Lenger3/esp32-rfid-ev-charger/hardware/LEHIM-SABLONU.pdf

# LEHIM SABLONU — 100 x 100 mm · 1:1 OLCek

Yazdirirken 'Actual size / %100' secin. Cetvel kontrolu: alttaki 50 mm olcegi olcun.

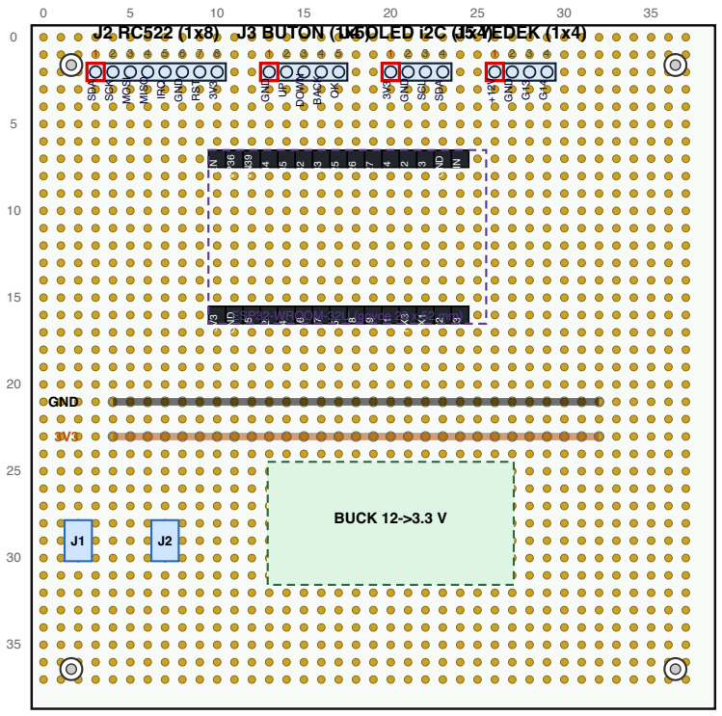
[picture p5: figure]
SDA; SCK; MOSI; MISO; IRQ; GND; RST; DOWN; BACK; J3 BUTON (1x5); SCL; J4 OLED i2C (1x4); J5 YEDEK (1x4); VIN; ESP32; -WROOM-32U (govde 26 x 52 mm); BUCK 12->3.3 V

0 | 10 | 20 | 30 | 40 | 50

OLCEK KONTROLU: bu cizgi tam 50 mm olmali

# LEHIM SIRASI

### 0 Olcek kontrolu: 50 mm cizgisi tam 50 mm mi?

### 1 GND rayi (satir 21, kolon 4-32) — 8 pin

2 3V3 rayi (satir 23, kolon 4-32) — 8 pin

### 3 ESP32 2x15 soket — once modulle hizala

### 4 J2 RC522 (satir 2, kolon 3-10)

### 5 J3 BUTON (satir 2, kolon 13-17)

### 6 J4 OLED i2C (satir 2, kolon 20-23)

### 7 J5 YEDEK (satir 2, kolon 26-29)

### 8 J1 + J2 12V klemens (satir 29)

### 9 Buck cikisi raylara + 100uF

### 10 Guc verme testi: 3V3 rayinda 3.3 V

### 11 Modulleri tak, firmware yukle

## KRITIK

- Kirmizi kare = pin 1. Tum header'larda ayni yon.
- RC522'ye 5 V VERME — aninda olur.
- Raylar birbirine degmemeli: 2 delik (5.08 mm) ara var.
- ESP32 sirasi 22.86 mm = 9 delik. Kayarsa modul girmez.
- OLED'e giden 4 tel: 3V3, GND, SCL(G22), SDA(G21)
- RES/A0/CS modul tarafinda: RES->3V3, A0->GND, CS->GND
