Lenger3/esp32-rfid-ev-charger/docs/img/panel-device.png

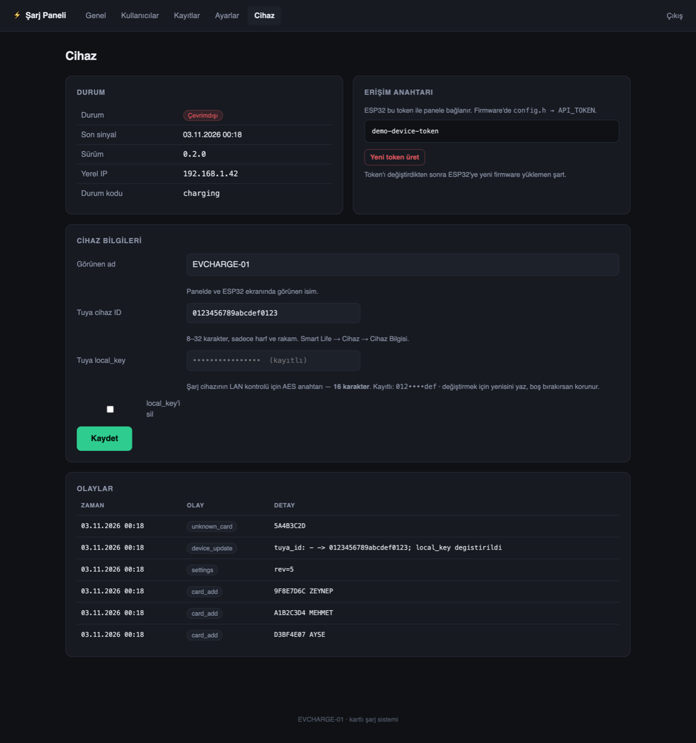
docs/img/panel-device.png
