Lenger3/esp32-rfid-ev-charger/docs/img/panel-sessions.png

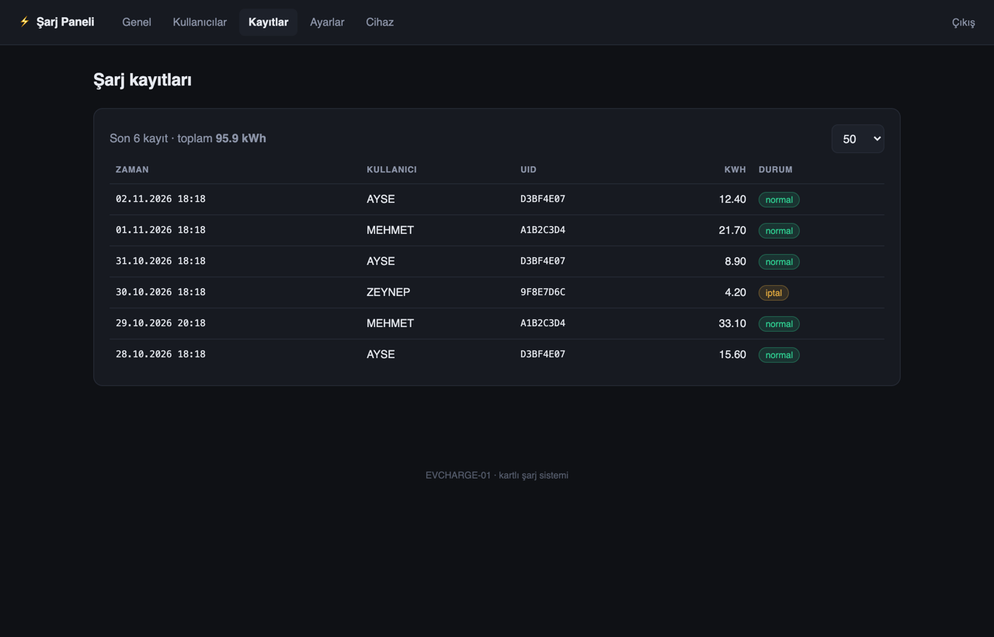
docs/img/panel-sessions.png
