Lenger3/esp32-rfid-ev-charger/docs/img/panel-users.png

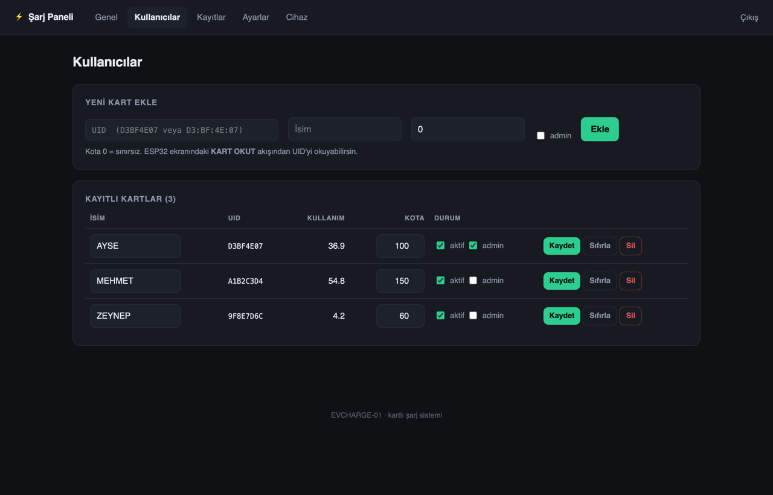
docs/img/panel-users.png
