Lenger3/esp32-rfid-ev-charger/docs/img/pcb-layout.png

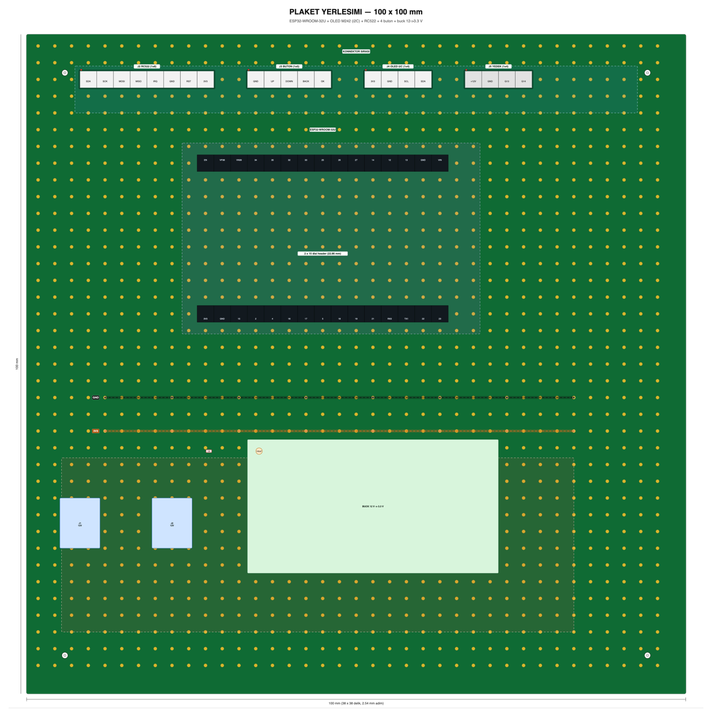
docs/img/pcb-layout.png
