Lenger3/esp32-rfid-ev-charger/docs/img/pcb-moduls.png

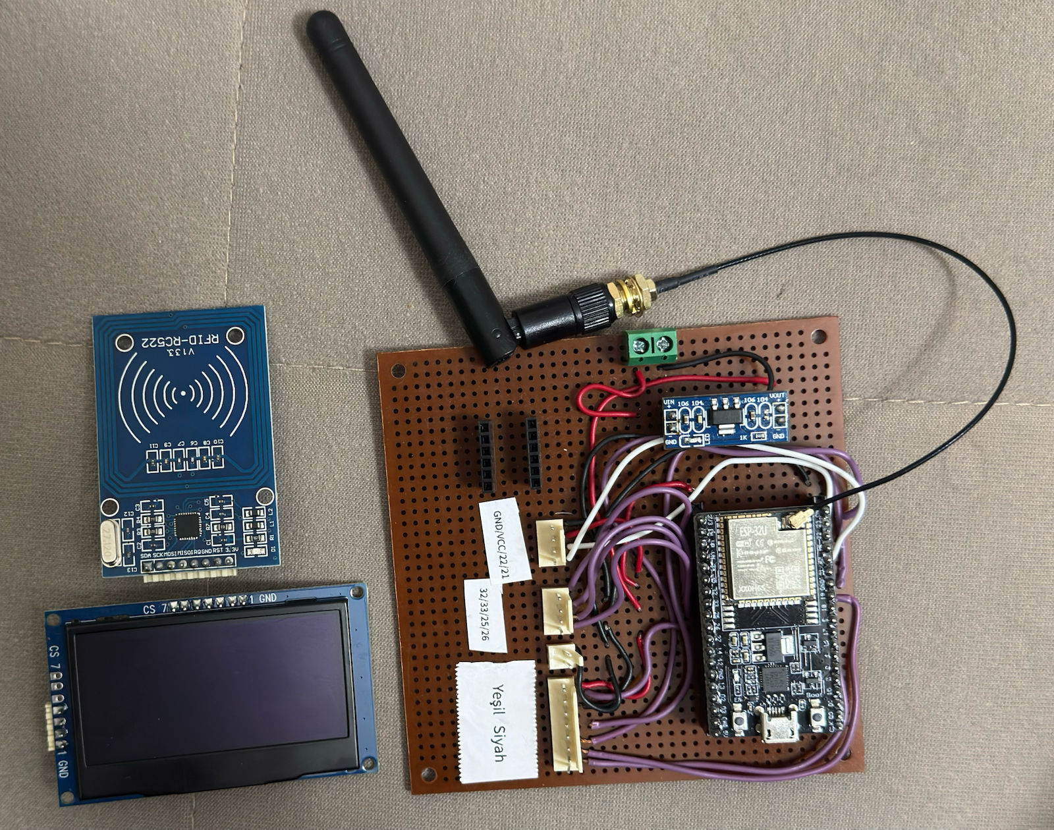
docs/img/pcb-moduls.png
