Lenger3/esp32-rfid-ev-charger/docs/img/social-preview.png

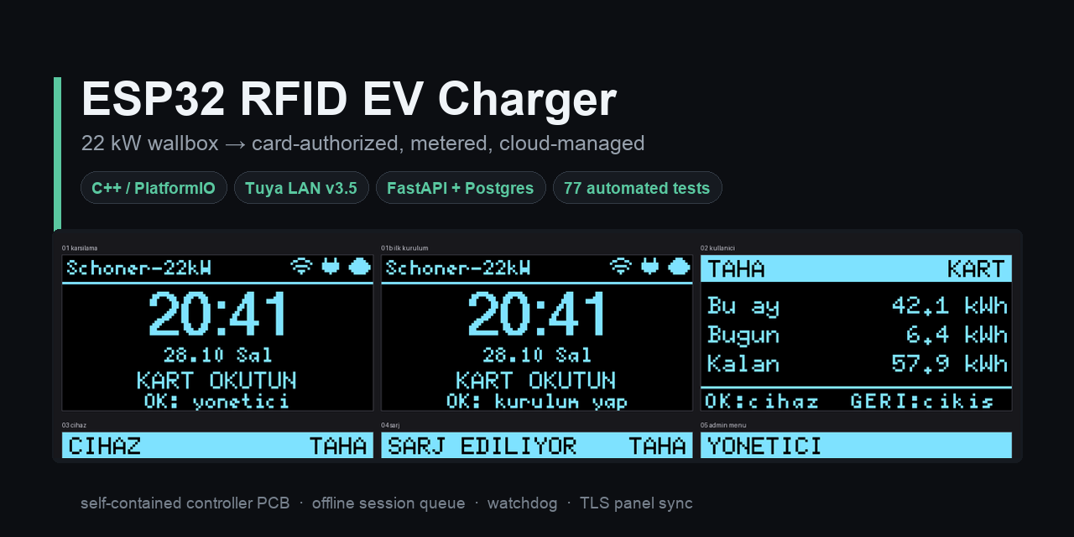
docs/img/social-preview.png
