Lenger3/esp32-rfid-ev-charger/firmware/kart_sistem/sim/out/01_karsilama.png

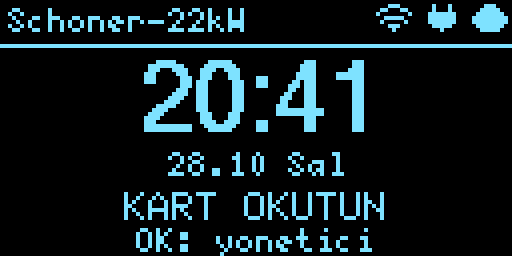
firmware/kart_sistem/sim/out/01_karsilama.png
