Lenger3/esp32-rfid-ev-charger/firmware/kart_sistem/sim/out/02_kullanici.png

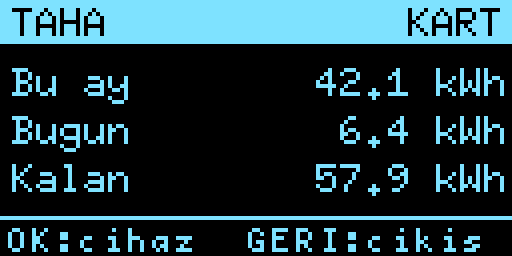
firmware/kart_sistem/sim/out/02_kullanici.png
