Lenger3/esp32-rfid-ev-charger/firmware/kart_sistem/sim/out/03_cihaz.png

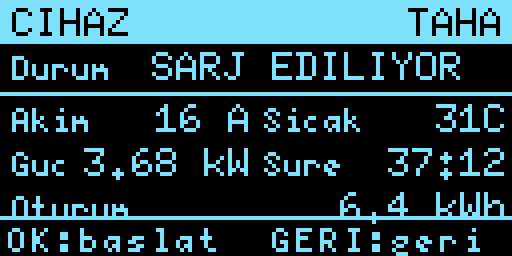
firmware/kart_sistem/sim/out/03_cihaz.png
