Lenger3/esp32-rfid-ev-charger/firmware/kart_sistem/sim/out/04_sarj.png

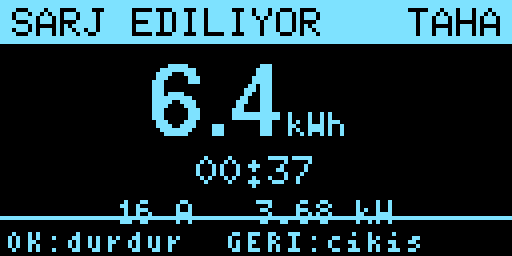
firmware/kart_sistem/sim/out/04_sarj.png
