Lenger3/esp32-rfid-ev-charger/firmware/kart_sistem/sim/out/05_admin_menu.png

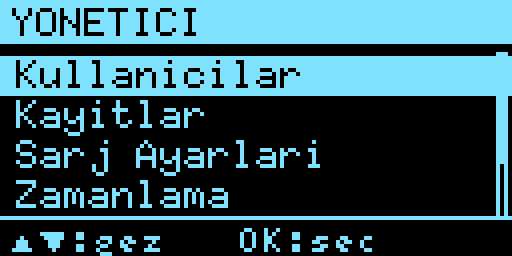
firmware/kart_sistem/sim/out/05_admin_menu.png
