Lenger3/esp32-rfid-ev-charger/firmware/kart_sistem/sim/out/06_kullanicilar.png

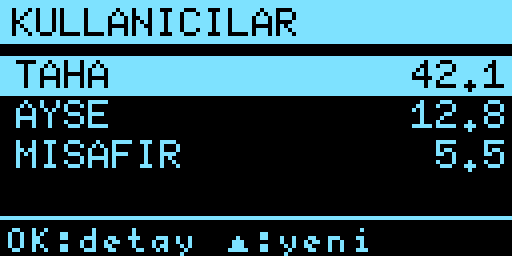
firmware/kart_sistem/sim/out/06_kullanicilar.png
