Lenger3/esp32-rfid-ev-charger/firmware/kart_sistem/sim/out/07_kayitlar.png

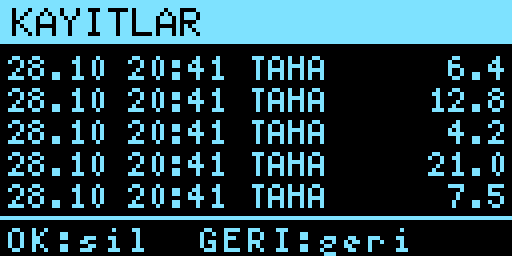
firmware/kart_sistem/sim/out/07_kayitlar.png
