Lenger3/esp32-rfid-ev-charger/firmware/kart_sistem/sim/out/08_ayarlar.png

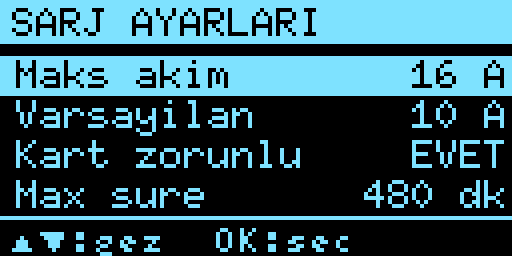
firmware/kart_sistem/sim/out/08_ayarlar.png
