Lenger3/esp32-rfid-ev-charger/firmware/kart_sistem/sim/out/09_zamanlama.png

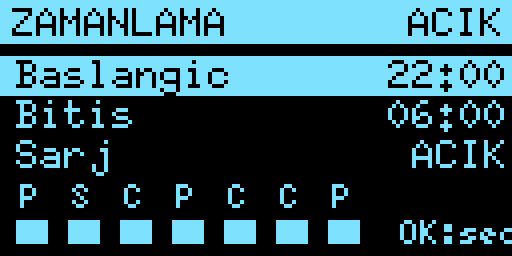
firmware/kart_sistem/sim/out/09_zamanlama.png
