Lenger3/esp32-rfid-ev-charger/firmware/kart_sistem/sim/out/10_pin.png

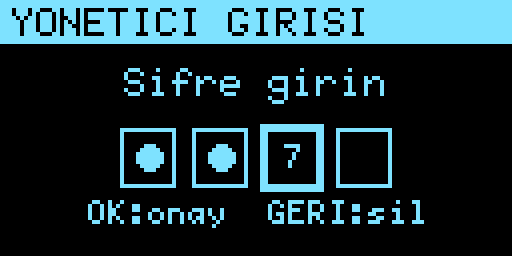
firmware/kart_sistem/sim/out/10_pin.png
