Lenger3/esp32-rfid-ev-charger/firmware/kart_sistem/sim/out/11_red.png

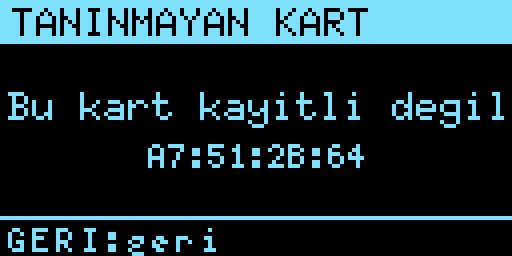
firmware/kart_sistem/sim/out/11_red.png
