Lenger3/esp32-rfid-ev-charger/firmware/kart_sistem/sim/out/12_cihazbilgi.png

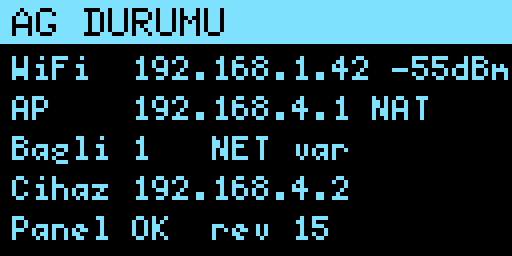
firmware/kart_sistem/sim/out/12_cihazbilgi.png
