Lenger3/esp32-rfid-ev-charger/firmware/kart_sistem/sim/out/13_butontest.png

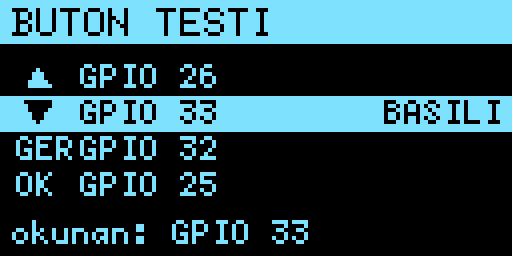
firmware/kart_sistem/sim/out/13_butontest.png
