Lenger3/esp32-rfid-ev-charger/firmware/kart_sistem/sim/out/14_menu_kaydirma.png

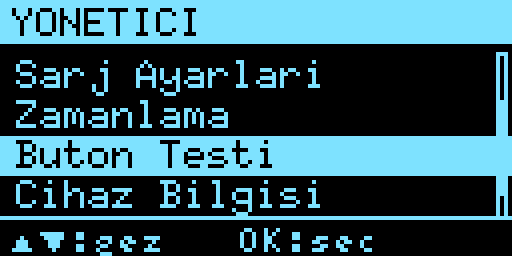
firmware/kart_sistem/sim/out/14_menu_kaydirma.png
