Lenger3/esp32-rfid-ev-charger/firmware/kart_sistem/sim/out/15_onay.png

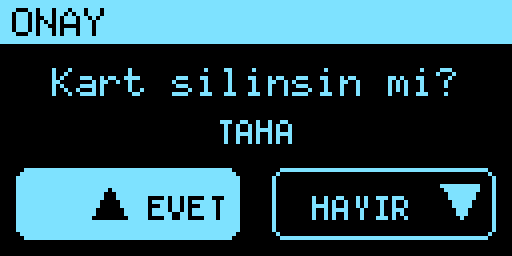
firmware/kart_sistem/sim/out/15_onay.png
