Lenger3/esp32-rfid-ev-charger/hardware/_pdf.png

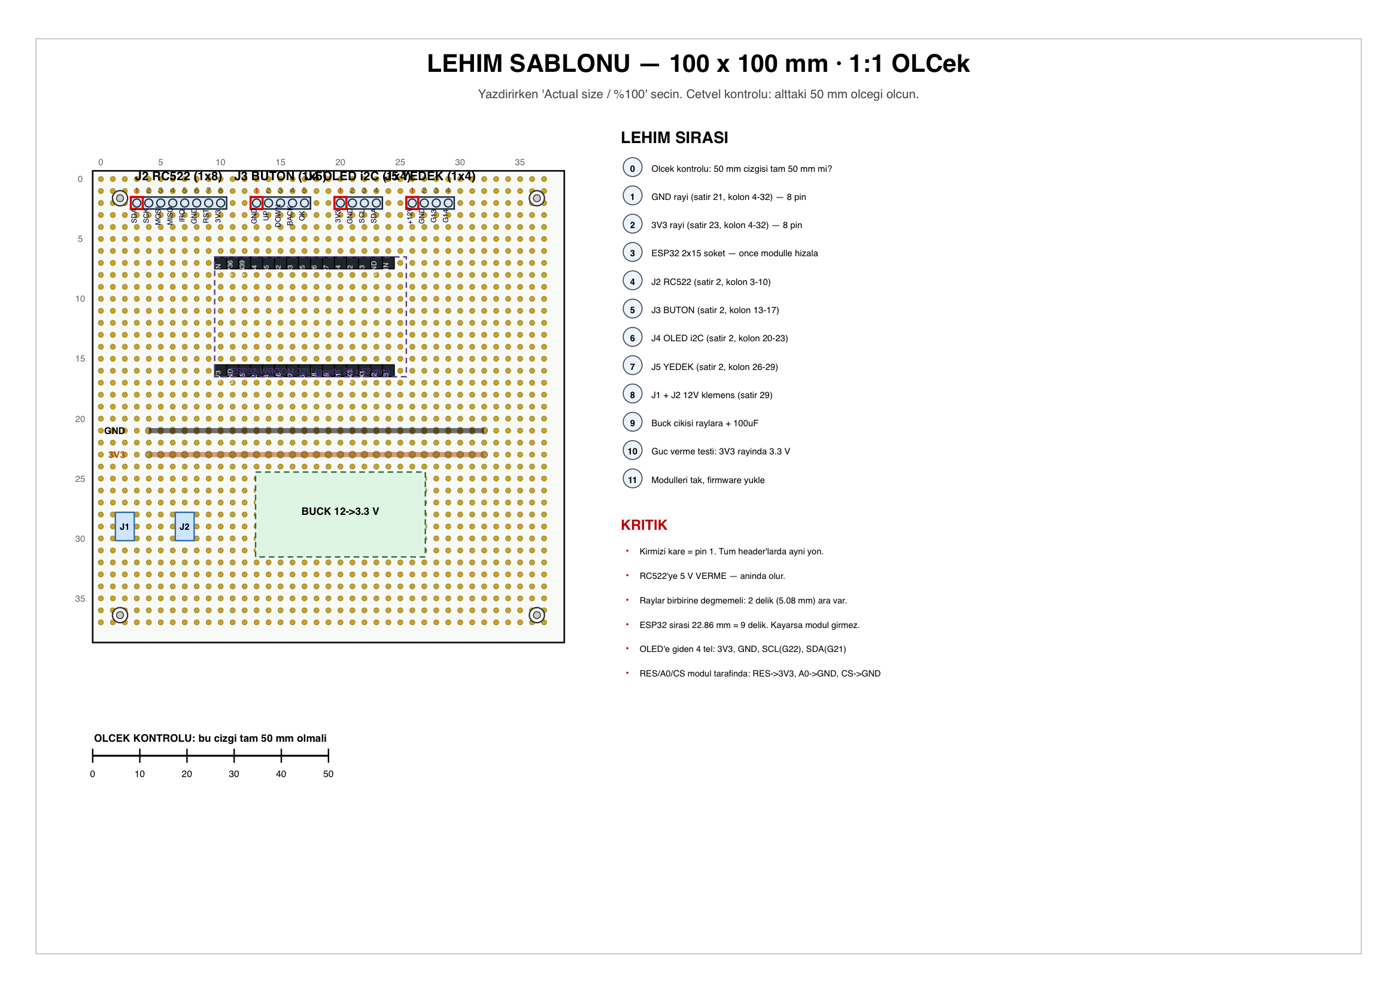
hardware/_pdf.png
