Lenger3/esp32-rfid-ev-charger/hardware/lid_bottom.png

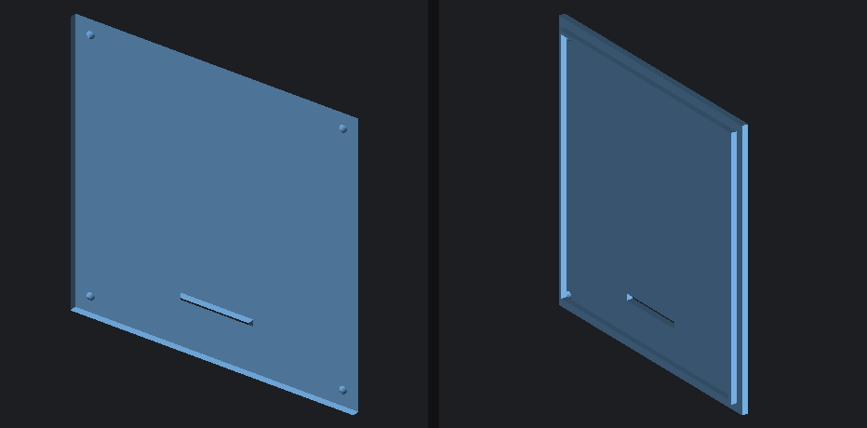
hardware/lid_bottom.png
