Lenger3/esp32-rfid-ev-charger/hardware/preview.png

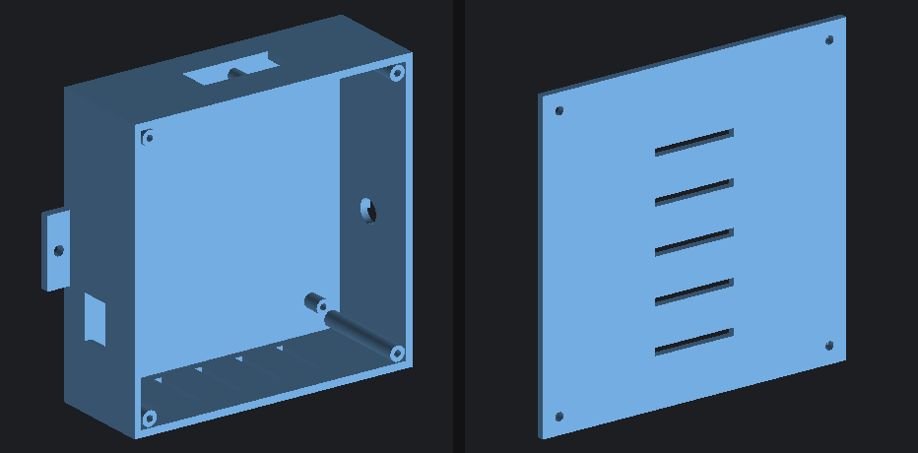
hardware/preview.png
