Lenger3/esp32-rfid-ev-charger/panel/screens/04_settings.png

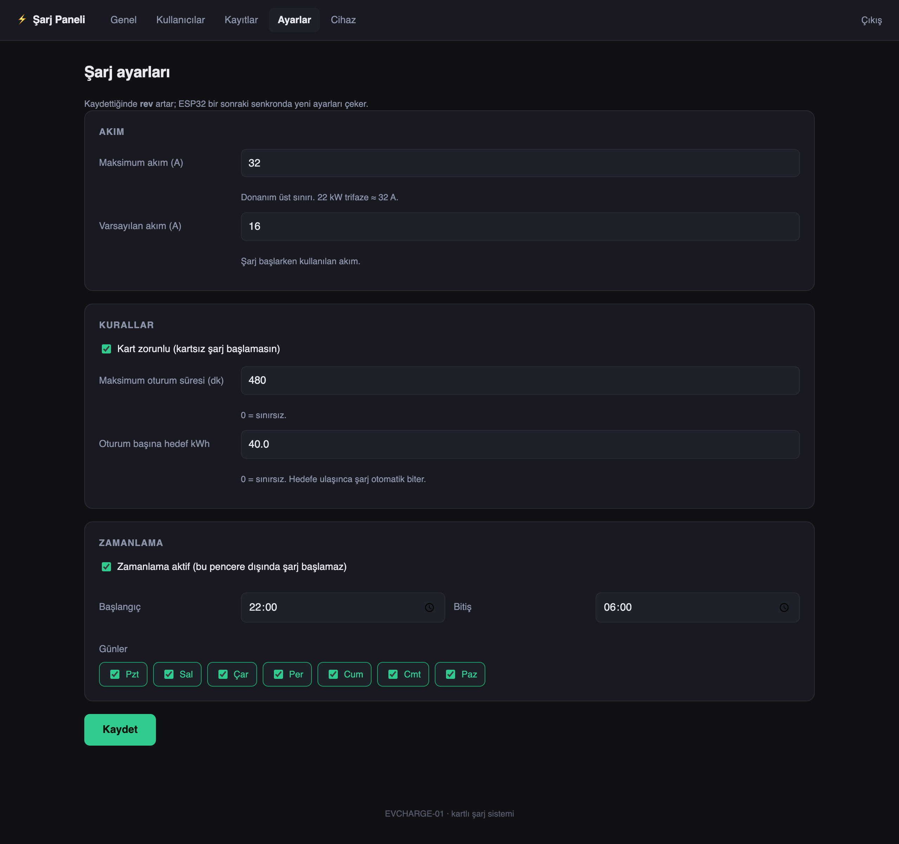
panel/screens/04_settings.png
