Lenger3/esp32-rfid-ev-charger/hardware/body_pcb.stl

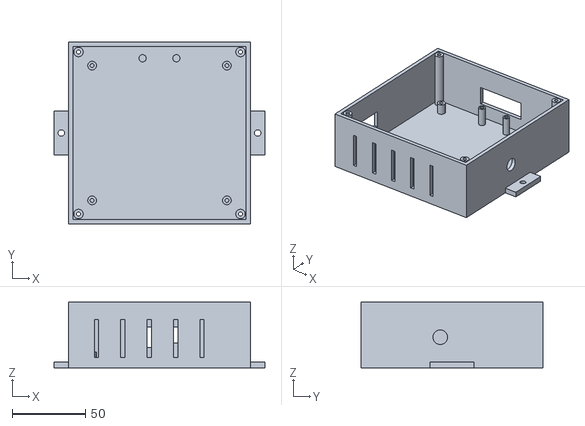
[picture p31: CAD file, 2026-11-03]
hardware/body_pcb.stl
144.0 x 124.0 x 45.0
