Lenger3/esp32-rfid-ev-charger/hardware/body.stl

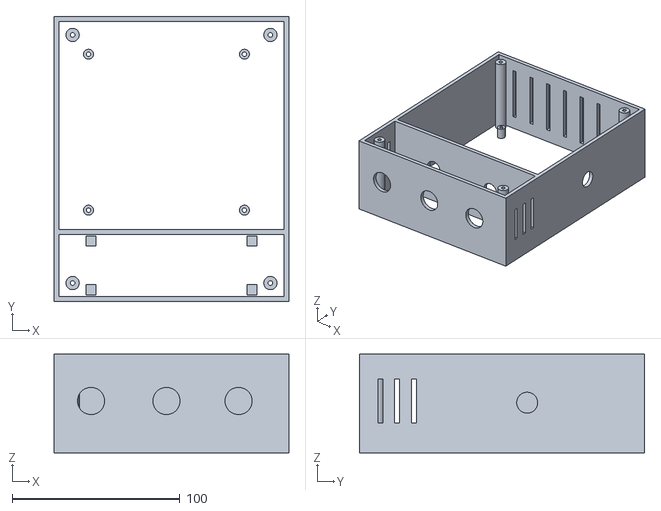
[picture p32: CAD file, 2026-11-03]
hardware/body.stl
140.0 x 170.0 x 59.0
