Lenger3/esp32-rfid-ev-charger/hardware/lid_pcb.stl

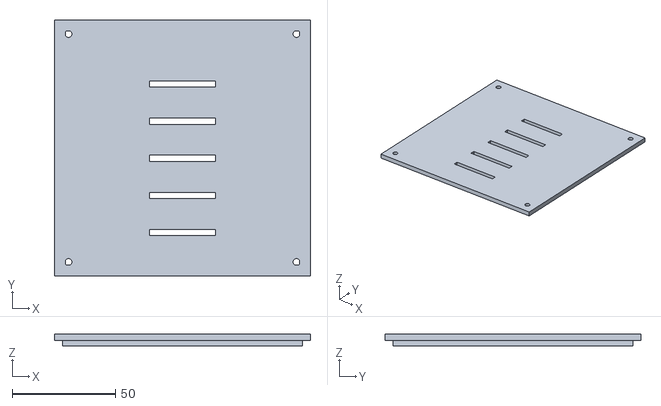
[picture p33: CAD file, 2026-11-03]
hardware/lid_pcb.stl
124.0 x 124.0 x 5.60
