Lenger3/esp32-rfid-ev-charger/hardware/lid.stl

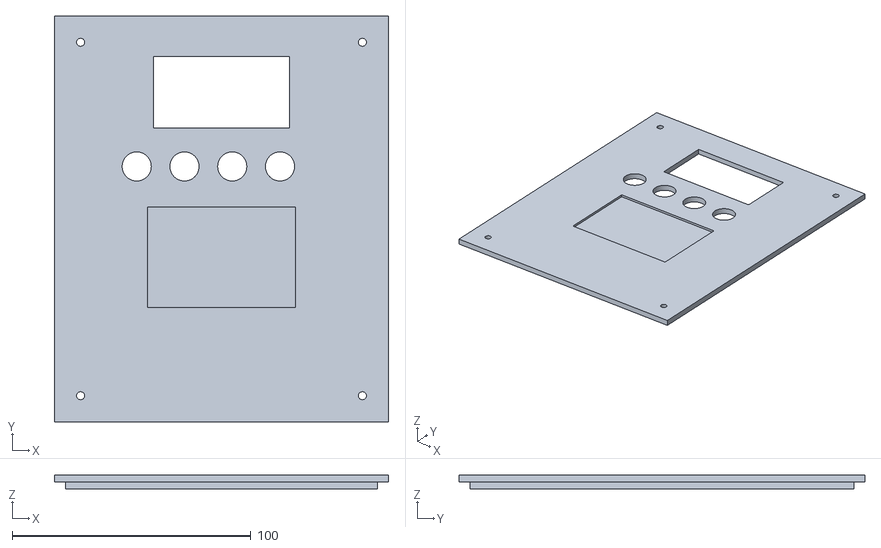
[picture p34: CAD file, 2026-11-03]
hardware/lid.stl
140.0 x 170.0 x 6.00
