Lenger3/esp32-rfid-ev-charger/hardware/pcb_wiring.png

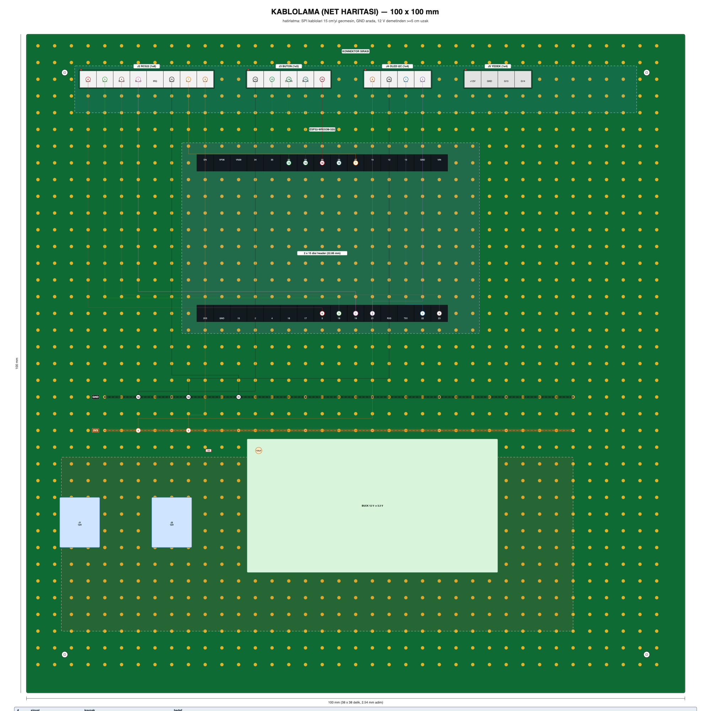
hardware/pcb_wiring.png
