Lenger3/esp32-rfid-ev-charger/(commit log)

2026-11-03 new file: docs/img/pcb-moduls.png new file: docs/img/pcb.png
2026-11-03 Update PCB image in README.md
